mp911de/scare-pi/(list of files, drawings)

Other design files:
docs/scare-pi.fzz
