mp911de/scare-pi/(commit log)

2026-10-18 Initial import.
    [scare-pi.fzz]
2026-10-28 Add LD2420 calibration.
2026-10-28 Add LED strip support for mouth.
